louayakermi2816-gif/roufix/docs/images/banc_entrees.png

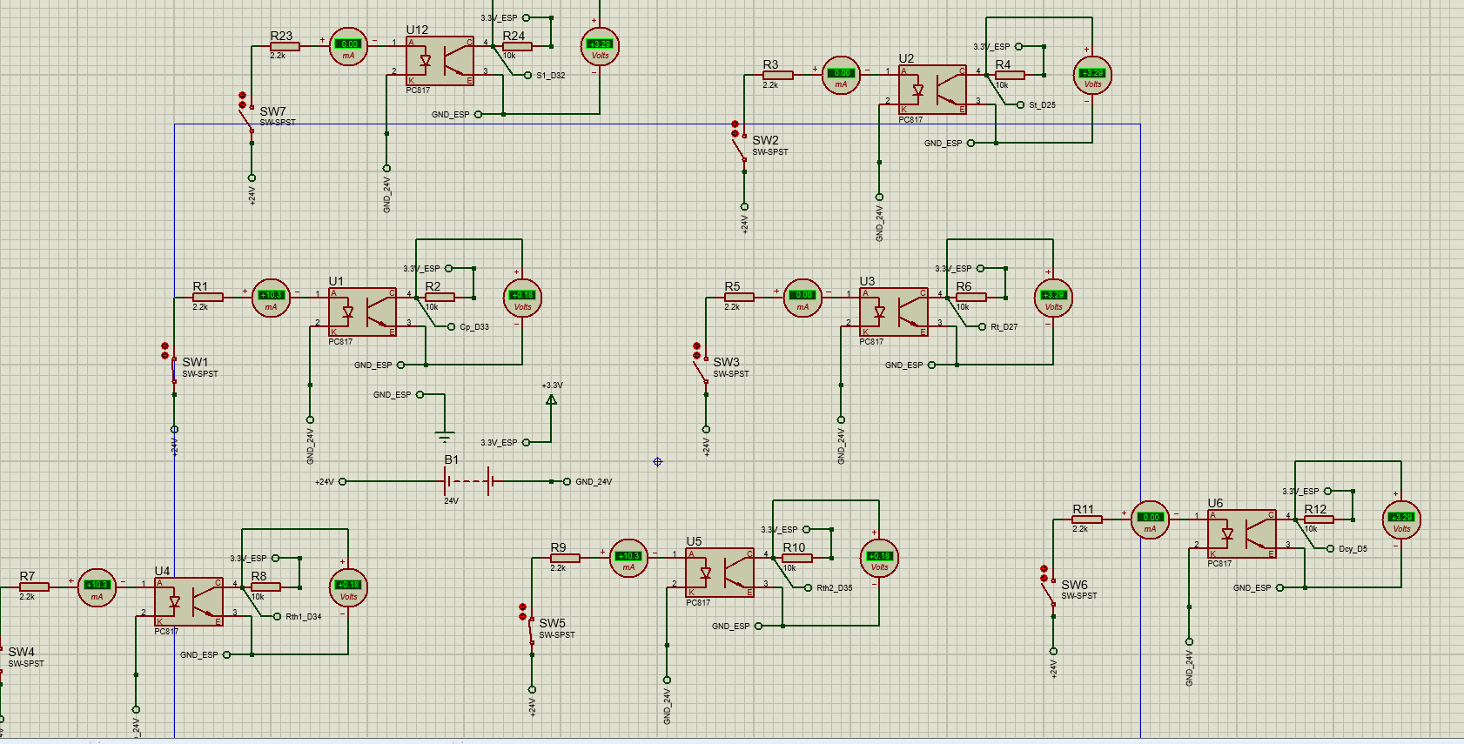
docs/images/banc_entrees.png
