louayakermi2816-gif/roufix/docs/images/banc_sortie_nominal.png

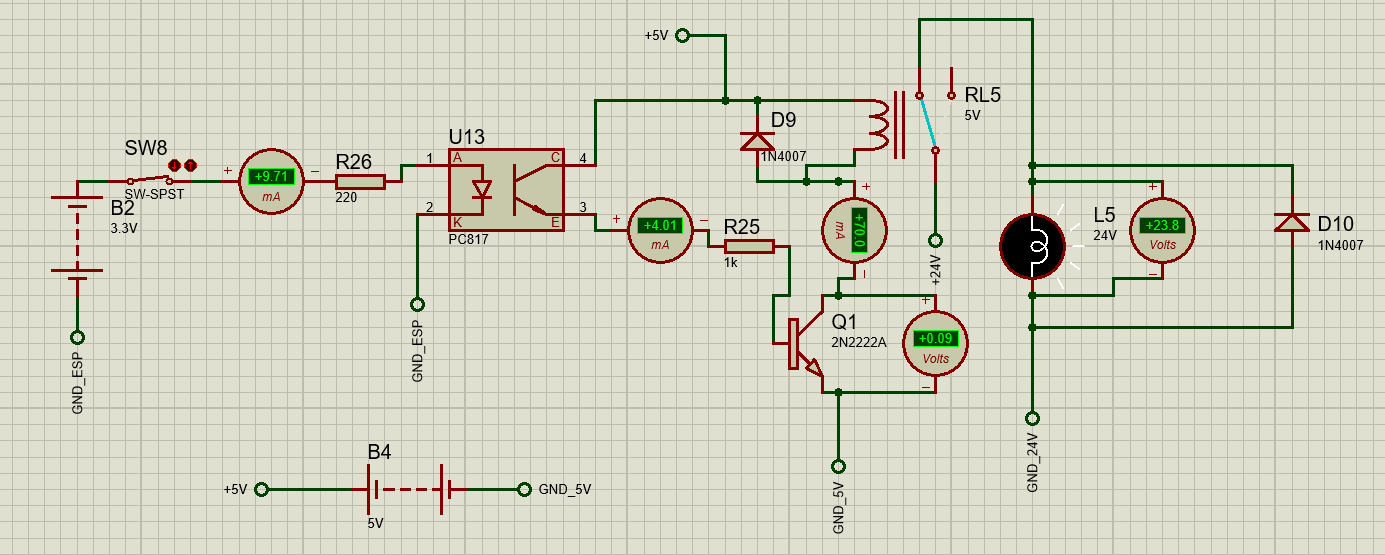
docs/images/banc_sortie_nominal.png
