louayakermi2816-gif/roufix/docs/images/isolement_500V.png

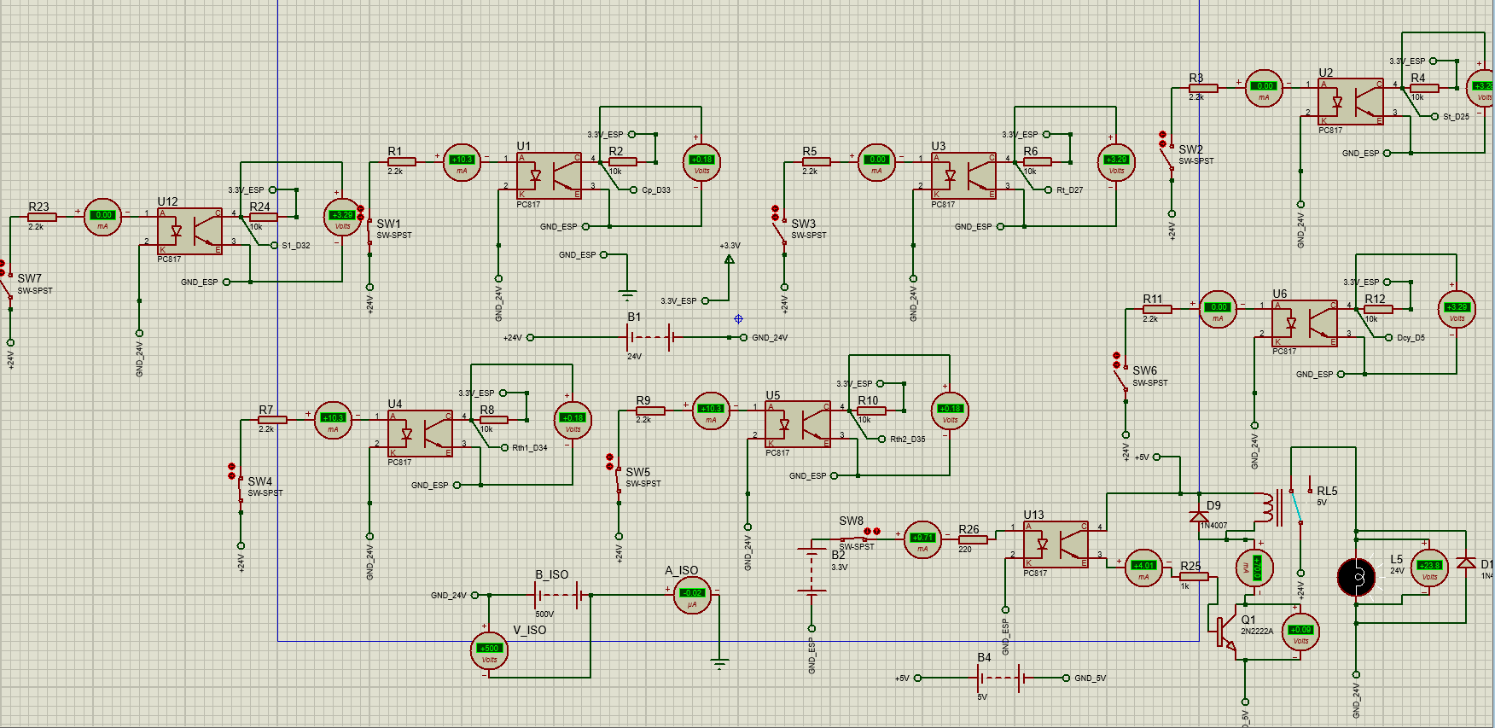
docs/images/isolement_500V.png
