louayakermi2816-gif/roufix/docs/images/rouelibre_avec_D9.png

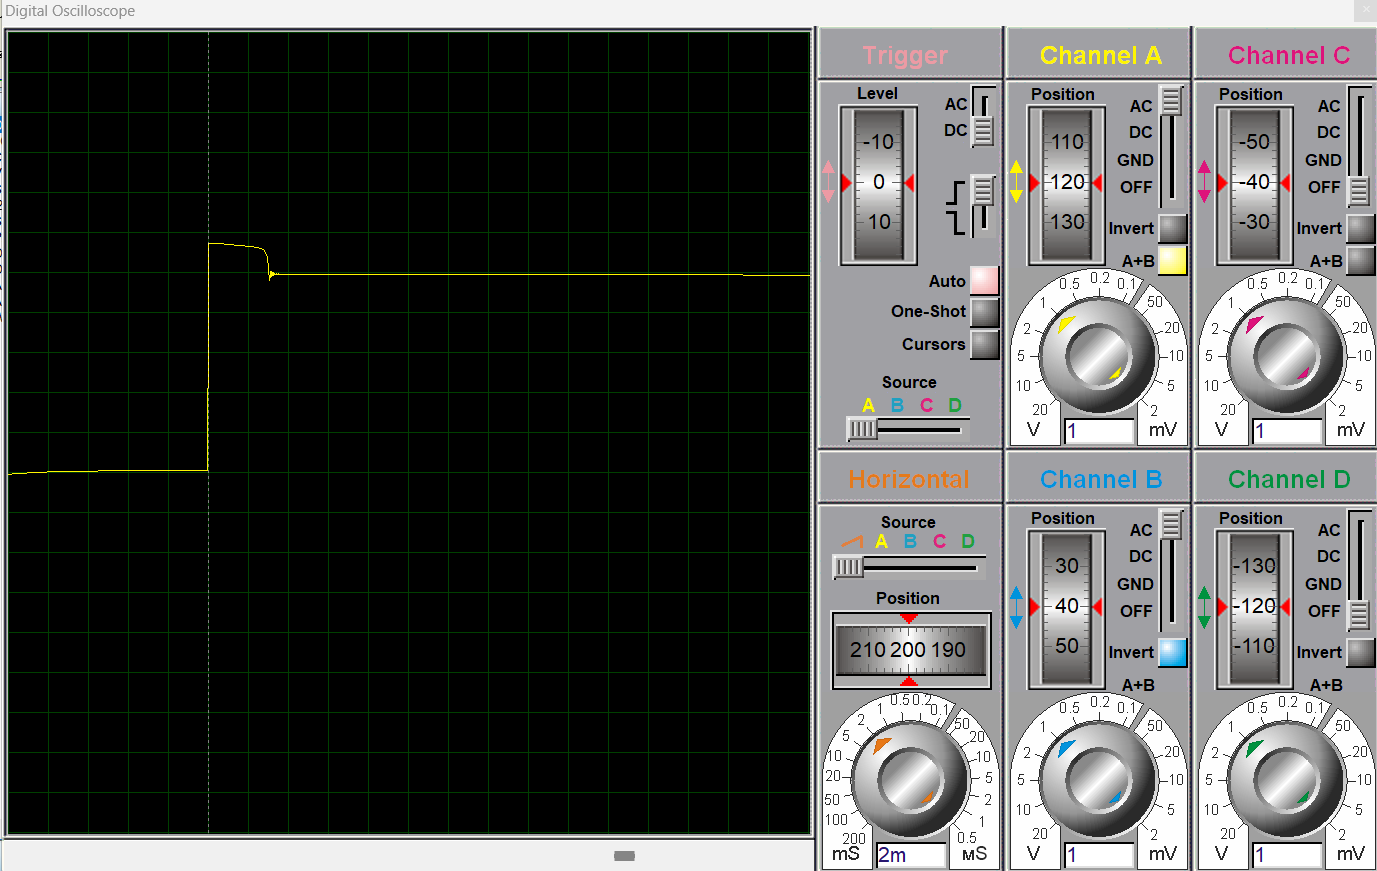
docs/images/rouelibre_avec_D9.png
