louayakermi2816-gif/roufix/docs/images/rouelibre_sans_D9.png

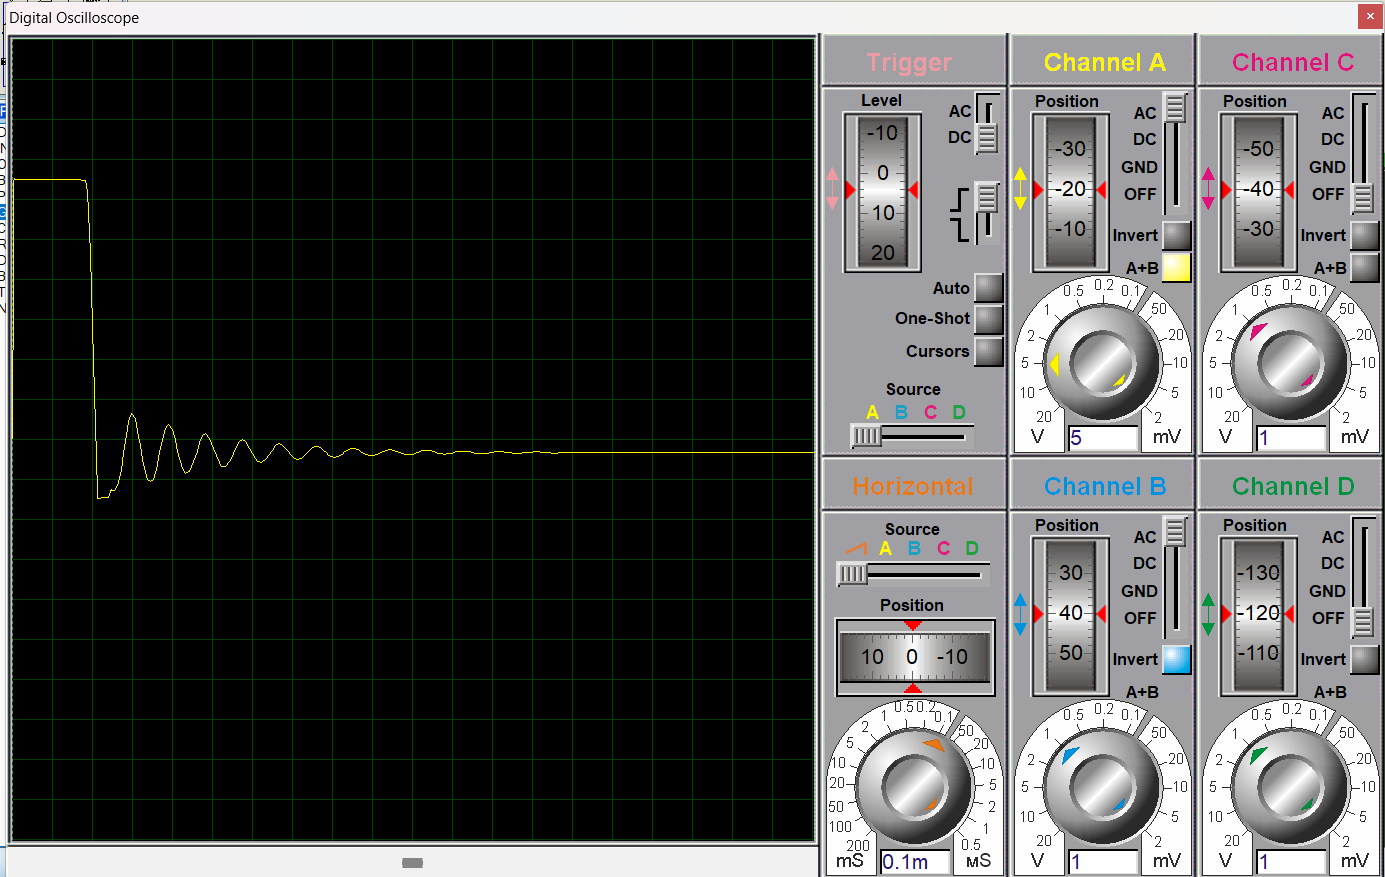
docs/images/rouelibre_sans_D9.png
