louayakermi2816-gif/roufix/docs/images/wokwi_capot_redemarrage.png

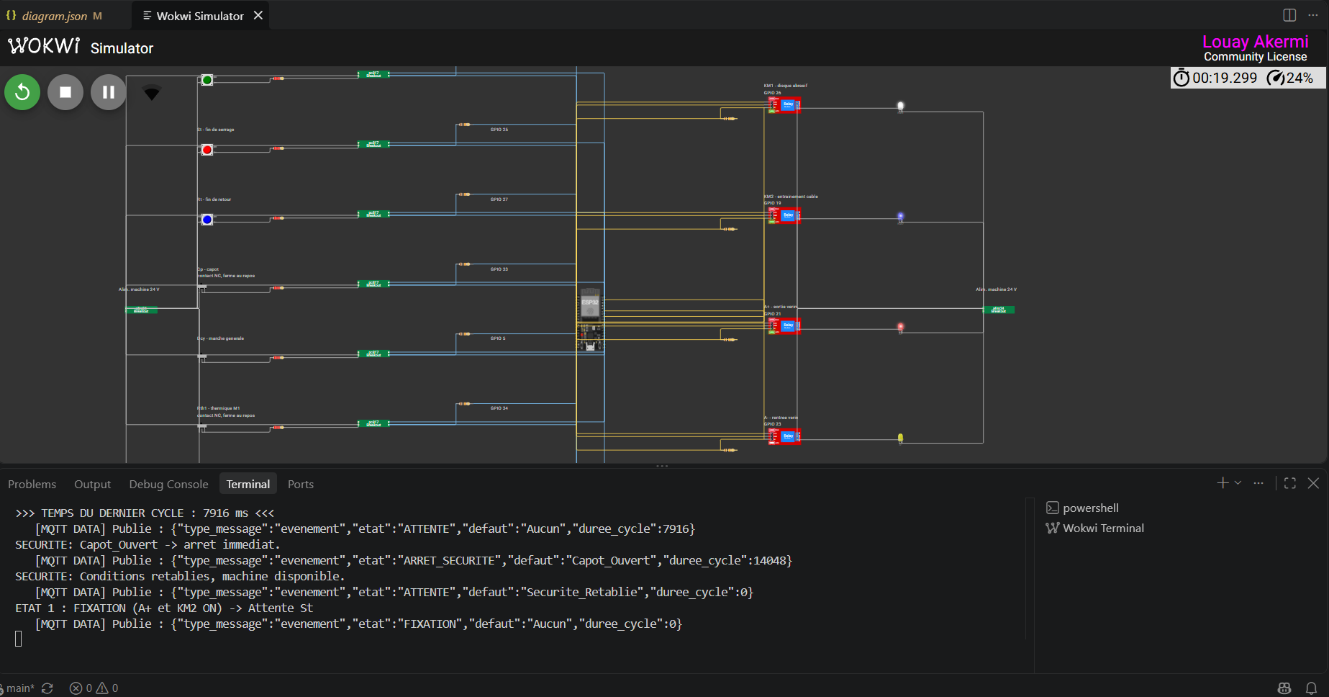
docs/images/wokwi_capot_redemarrage.png
