louayakermi2816-gif/roufix/docs/images/wokwi_panne_pc817_capot.png

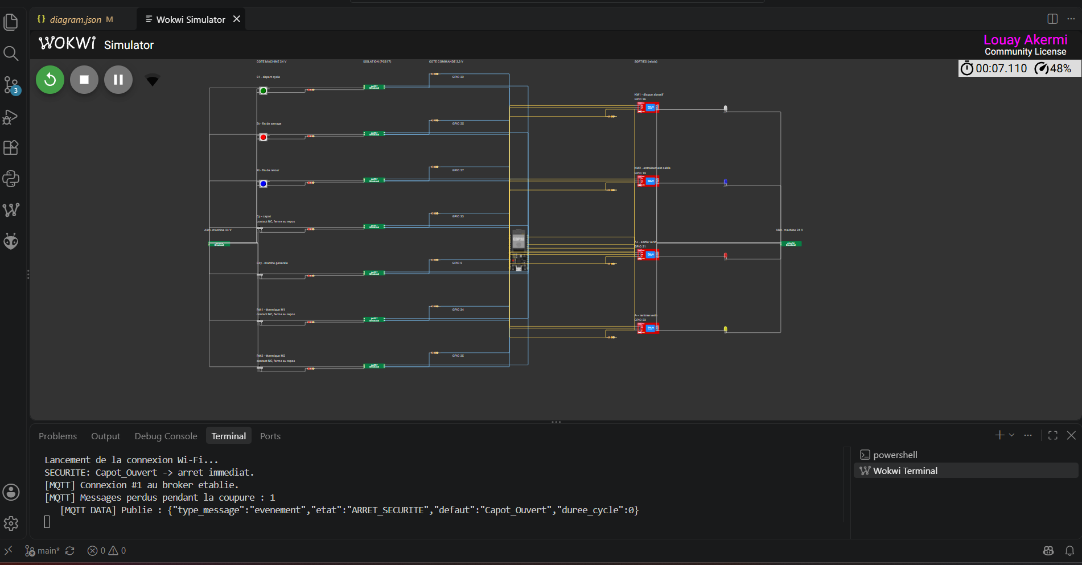
docs/images/wokwi_panne_pc817_capot.png
