louayakermi2816-gif/roufix/docs/images/carte_isolation.pdf

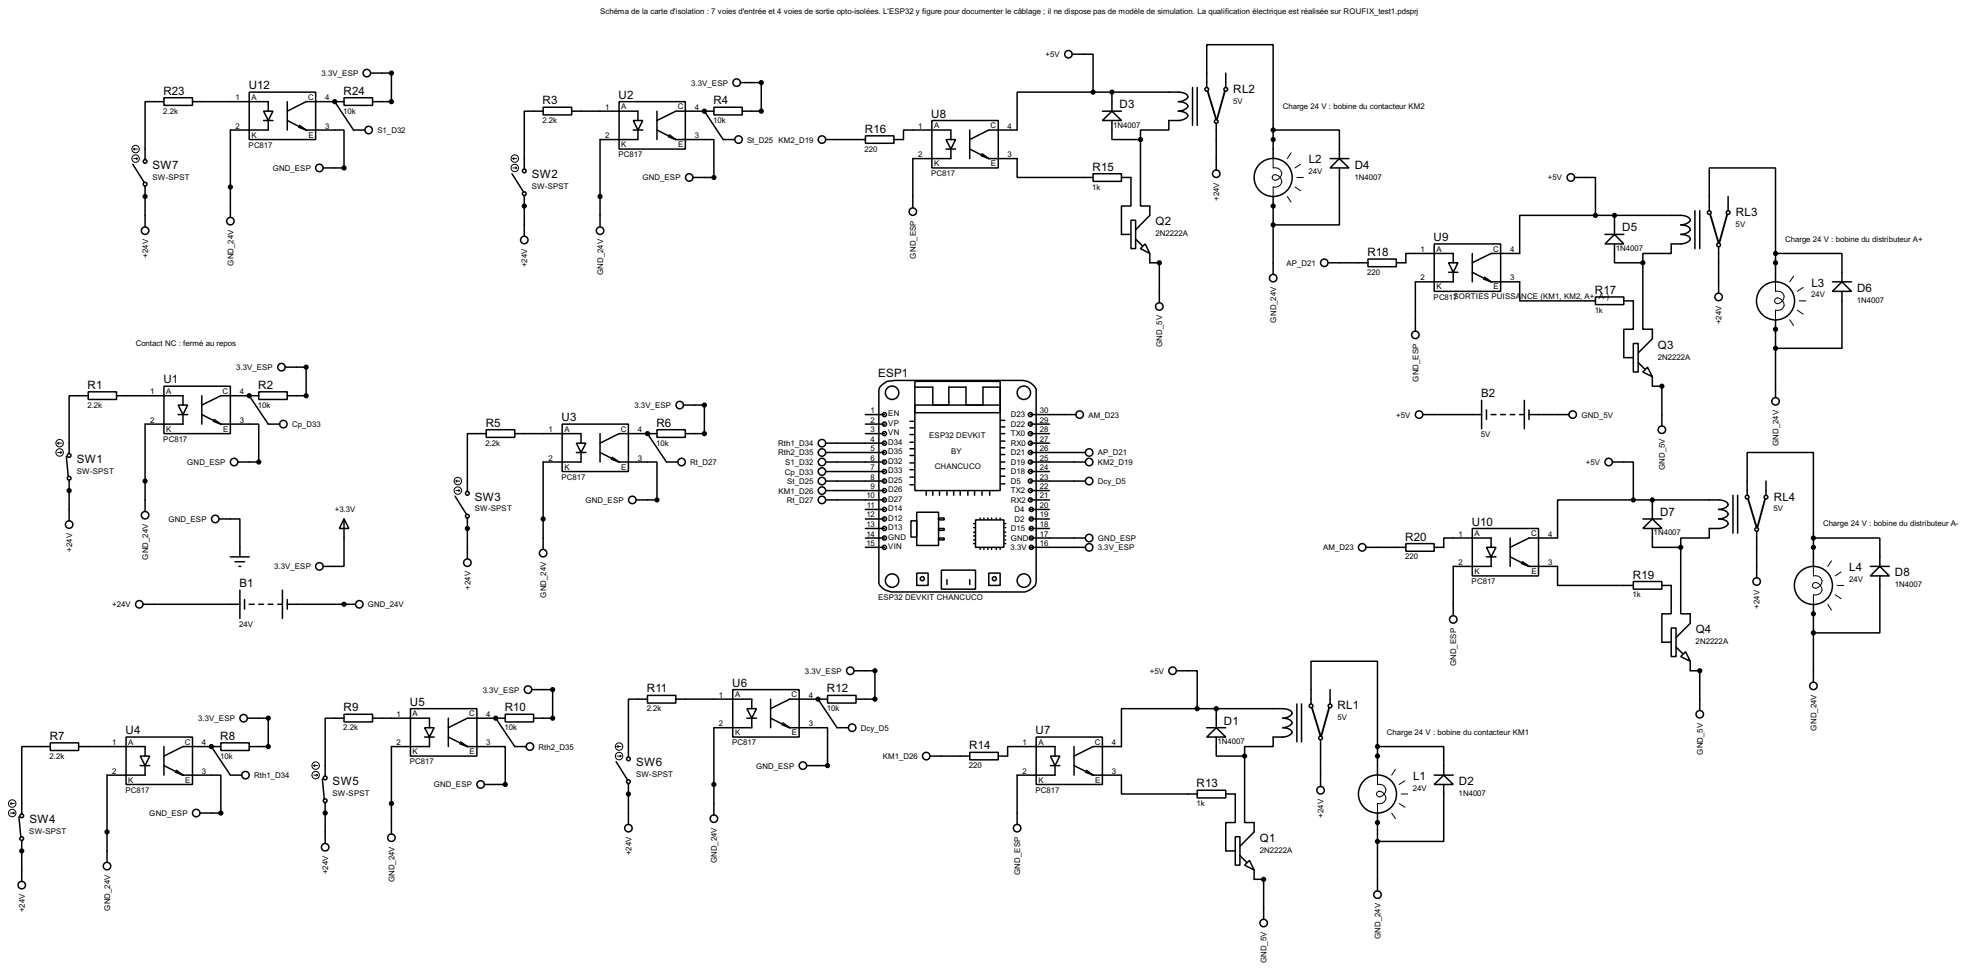
[picture p8: page 1]

Schéma de la carte d'isolation : 7 voies d'entrée et 4 voies de sortie opto-isolées. L'ESP32 y figure pour documenter le câblage ; il ne dispose pas de modèle de simulation. La qualification électrique est réalisée sur ROUFIX_test1.pdsprj

Charge 24 V : bobine du contacteur KM2

Charge 24 V : bobine du distributeur A+

Contact NC : fermé au repos

Charge 24 V : bobine du distributeur A-

Charge 24 V : bobine du contacteur KM1
