louayakermi2816-gif/roufix/(list of files, drawings)

Other design files:
proteus/ROUFIX_banc_isolement.pdsprj
proteus/ROUFIX_banc_rouelibre.pdsprj
proteus/ROUFIX_doc.pdsprj
proteus/ROUFIX_test.pdsprj
