louayakermi2816-gif/roufix/(commit log)

2026-09-16 ROUFIX: ESP32 control firmware, Wokwi simulation, Proteus isolation stage, Node-RED OEE/SPC supervision and Ollama diagnostic flow
    Four-layer retrofit architecture for the COFAT cable-stripping machine (internship, June-Aug 2026):
    - ESP32 firmware: safety-first state machine, debounced start, MQTT telemetry with last-will and non-blocking degraded mode
    - Wokwi diagram + build script for the VS Code simulator
    - Proteus ISIS projects for the optocoupler / opto-relay isolation stage
    - Node-RED flow: piece counter, OEE (TRS), SPC +/-3 sigma drift detection, dashboard, local-LLM diagnosis with fallback
    [ROUFIX_doc.pdsprj, ROUFIX_test.pdsprj]
2026-09-18 Sync repository with the final internship state (September 2026)
    The initial commit was taken from an early-August snapshot (stagecofat).
    Replace every artefact with the version validated for the report:
    - firmware: jury version of roufix_esp32.ino (3 s stripping timer,
    safety state repeated in heartbeats, lost-message counter)
    - diagram.json: Wokwi layout with each part labelled (S1, St, Rt, Dcy,
    Cp, Rth1/2, KM1/2, A+/A-) and serial monitor wired
    - node-red/flows.json: live flow of 4 September - 3-tab dashboard,
    measured quality (interrupted cycle = reject), operating stops vs
    machine faults, severity-indexed maintenance referential with
    enum-constrained JSON schema, per-operator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
    [ROUFIX_doc.pdsprj, ROUFIX_test.pdsprj]
2026-09-22 Qualify the isolation layer on a Proteus bench, and make the cover fail-safe
    The Proteus design was a passive schematic: inputs driven by LOGICSTATE
    primitives on the 5 V rail, outputs read by eye, ESP32 symbol unconnected.
    It is now a characterisation bench, with the ESP32 represented by its
    electrical equivalent from the datasheet (3.3 V nominal, 2.64 V worst-case
    V_OH) and every reading compared against a datasheet limit.
    Bench (docs/banc_proteus.md, 13 essais):
    - 7 input channels: contact under 24 V, 2.2k, PC817, 10k pull-up. Levels
    hold over 24 V +/-10 %: 0.18 V closed (limit 0.825 V), 3.29 V open
    (limit 2.475 V). A broken wire reads high, i.e. "stop".
    - output channel KM1: 9.7 mA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
    [ROUFIX_banc_isolement.pdsprj, ROUFIX_banc_rouelibre.pdsprj, ROUFIX_test.pdsprj]
2026-09-24 Rebuild the Proteus files so each one holds exactly one job
    The four designs had drifted: ROUFIX_test still carried the August output
    stage (330 Ohm, LOGICSTATE, generic 2N2222) even though the report quotes
    the qualified one, ROUFIX_doc was the whole August schematic, and the
    isolation bench had lost its 500 V chain when the counter-test was removed.
    - ROUFIX_test: nominal bench, rebuilt from the qualified design. B2 back to
    3.3 V and the CTR=0 override removed, both left over from the worst-case
    runs. Reads 10.3 mA / 0.18 V on the three closed input channels, 0 / 3.29 V
    on the four open ones, 9.71 / 4.01 / 70.0 mA, 0.09 V and 23.8 V on the
    output channel.
    - ROUFIX_banc_isolement: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
    [ROUFIX_banc_isolement.pdsprj, ROUFIX_banc_rouelibre.pdsprj, ROUFIX_doc.pdsprj, ROUFIX_test.pdsprj]
2026-09-28 Draw the isolation layer in the Wokwi simulation
    The Wokwi diagram wired every switch straight between a GPIO and ground
    and hung every LED straight off a GPIO, so the simulation that runs the
    firmware, the MQTT link and the supervision showed none of the isolation
    the design depends on. Wokwi has no transistor, diode, optocoupler or
    floating supply, so the layer is modelled by its behaviour instead:
    - chips/pc817: an input optocoupler as a custom chip. It applies the
    contract measured on the Proteus bench - LED driven, collector pulled
    low; otherwise the collector is released, never driven high, so the
    10k pull-up of the schematic sets the idle level as on the real card.
    A "defaut"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
2026-09-28 Start M1 on S1 only, and hold the relay inputs low during boot
    M1 used to run as soon as Dcy, the cover and both thermal relays were
    all good, so closing the cover after a stop restarted the abrasive disc
    with no action from the operator. Machine-safety practice (ISO 12100,
    EN 60204-1) forbids a guard from restarting hazardous motion on its own,
    and the master GRAFCET of the report already required Dcy.Cp.S1 to leave
    step 0; the firmware did not follow it.
    M1 is now latched by the S1 press that starts the cycle and released by
    any safety stop, so after a stop it takes a fresh S1 to spin the disc
    again. Nothing published over MQTT changes: the KM1 state is not part of
    the telemetry, and Node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
2026-09-28 Let the PC817 chip take a fault while the simulation runs
    The chip only re-evaluated its output when the anode or cathode changed,
    so a fault set on a channel whose contact sits still (the cover, the
    thermal relays) had no effect until the next edge. It now also re-reads
    the "defaut" attribute every 20 ms.
    Demo recorded with the cover channel's PC817 failed open while the cover
    is closed: the ESP32 reads the same high level as an open cover or a cut
    wire, publishes ARRET_SECURITE / Capot_Ouvert and ignores S1. A failure
    of the isolation layer trips the safety instead of masking it.
    Captures in docs/images: the failed-PC817 demo, and the cover opened and
    closed during a cycle with KM1 stayi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
2026-09-28 Stop counting a reject when the cover is opened between two pieces
    The firmware kept the start time of the last cycle after it completed, so
    a safety stop with the machine idle - the operator opening the cover to
    load the next cable, the everyday case - published the time elapsed since
    that start (14 048 ms in a recorded session). Node-RED took it for an
    aborted cycle and counted a reject; with a zero duration instead, its
    old-firmware branch armed a flag that turned the next good piece into a
    reject. Either way quality and OEE dropped for no fault.
    - firmware: the cycle timer is cleared when a cycle completes, so an
    idle stop publishes duree_cycle = 0.
    - Node-RED, "Detection defaut machi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
2026-09-29 Move MQTT to test.mosquitto.org
    The public HiveMQ broker stopped answering from the test network: the
    connection opened but no CONNACK ever came, three attempts over forty
    seconds. broker.emqx.io behaved the same; test.mosquitto.org connected
    and returned a published message in about two seconds. With the broker
    silent, the simulated ESP32 and Node-RED could no longer see each other.
    The firmware and the Node-RED broker node both point to
    test.mosquitto.org; topics are unchanged. Checked by listening on the
    broker while the simulation ran: the retained "En ligne" status and the
    heartbeats arrive.
    [roufix_esp32.ino]
2026-09-29 Give the dashboard room and one colour scheme
    Visual changes only; no node logic is touched.
    - Every group was 12 units wide (642 px), so on a 1600-1900 px screen
    half the page stayed empty and the two tables of the supervisor tab
    scrolled sideways with their last columns cut off. Operator and
    supervisor groups are now 24 units, the OEE card 18; both tables show
    every column.
    - The title bar used the dashboard's default cyan, unrelated to the
    navy used by every card. Theme set to the cards' blue (#2c5aa0), title
    bar a darker navy, page background matched to the cards' soft grey.
    - Tabs in working order - operator, analysis, supervisor - with icons;
    "Pilotage Opérateur" gets i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
2026-09-29 Point cycle-time drifts at the pneumatics, not at the abrasive disc
    The referential behind the AI diagnosis listed disc wear and motor M1
    under-speed as the first causes of a long cycle. In this firmware the
    stripping phase is a fixed 3 s timer, so the disc cannot lengthen the
    cycle: only the clamp stroke (A+ until St) and the return stroke (A-
    until Rt) can, i.e. pneumatic pressure, the cylinder, the valve and the
    end-of-stroke sensors. The "long", "short" and "trend" lists now name
    those; disc and motor causes stay where they belong, in the thermal-
    fault lists reached through RTH1 and RTH2.
    Remeasured on the same six situations with llama3.2:1b: six distinct
    answers out of six, mean late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
2026-09-30 Keep the AI bounded: record the free-reasoning experiment
    Question raised: with a closed list of causes the model only ranks, and
    a lookup table would also give six distinct answers on six situations.
    To see whether freeing it would add real reasoning, the six situations
    were rerun with the causes given as guidance only and free-text causes,
    action and reasoning, on llama3.2:1b and llama3.2:3b, plus the same
    +17 % drift with a gradual and a sudden history.
    - 1B: 25 s mean (13 s bounded), 2/8 invalid JSON, a factual error in
    4 of 5 reasonings (M2 "driven by the cable", "gravité élevée" for a
    moderate case, a non-existent "ordinateur", a fixed timer called too
    long).
    - 3B: 37 s mean,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
2026-09-30 Let the operator describe the fault, and match it by meaning
    Measurement showed the diagnosis model adds little on its own: at 1 B
    parameters, under the closed list it mostly returns the list's order,
    ignored a free-text observation 5 times out of 6, and picked the right
    cause for 7 of 19 observations even when asked about the observation
    alone. A lookup table would do as well.
    The step that needs understanding - reading what a person saw or heard -
    now uses an embedding model, nomic-embed-text, already served by the
    local Ollama:
    - Pilotage tab: "Qu'observez-vous sur la machine ?" field, ANALYSER
    button and an observation card in its own group (a template of
    automatic height overlappe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
2026-09-30 Let the operator's observation name the organ, and the measurement the degree
    The embedding model separates organs well but not degrees of the same
    fault: during a severe drift, "the cylinder squeaks" or "air hisses near
    the cylinder" was asserted as "cylinder stuck". The observation is now
    compared with the whole drift family (both severity levels), and the
    cause displayed is the designated organ's cause at the measured severity.
    Pneumatic symptom sheets are rewritten so that each names the cylinder
    and carries the symptom that tells it from its neighbour.
    Benchmark on 52 phrases (docs/essais_ia/banc_observation.js): 48 right,
    3 uncertain, 1 wrong asserted, against 43 / 6 / 3 before.
2026-09-30 Give every cause its own action, and check the model keeps them together
    Four reference lists had grown to five causes while keeping four
    actions, so a cause could be shown with the action of another one (a
    severe drift displayed "cylinder stuck" with "clear the cable from the
    clamp"). Each list now carries one action per cause, in the same order,
    taken from the symptom sheets; the model sees each action once, and
    Extraire diagnostic replaces an action that belongs to none of the
    causes the model kept with the action of its first cause.
    The observation field is also emptied when the diagnosis card clears.
2026-10-02 Aligner les commentaires du firmware sur le GRAFCET du rapport
